indrora/minimole/screenshots-ripple/1.bmp

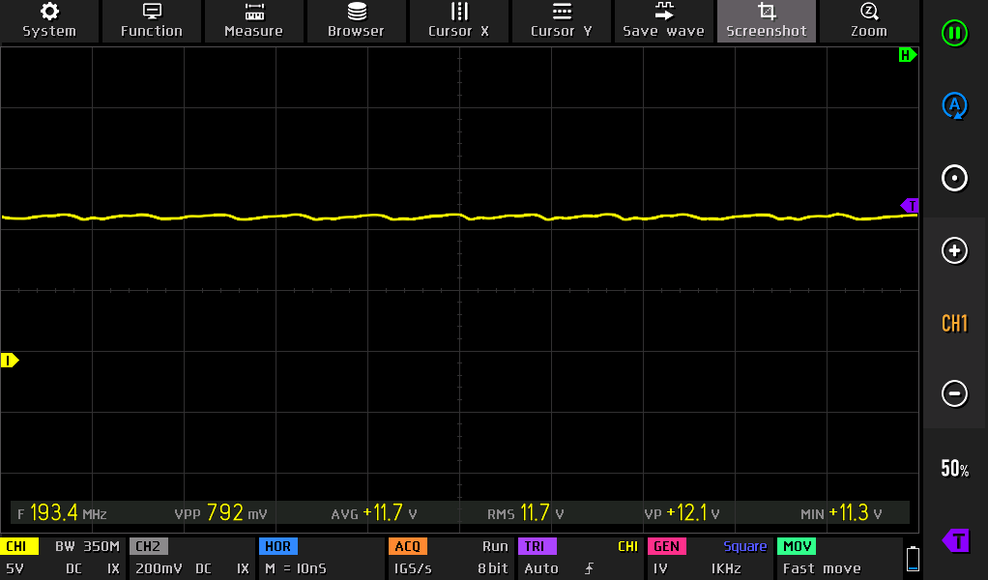
screenshots-ripple/1.bmp
