indrora/minimole/screenshots-ripple/2.bmp

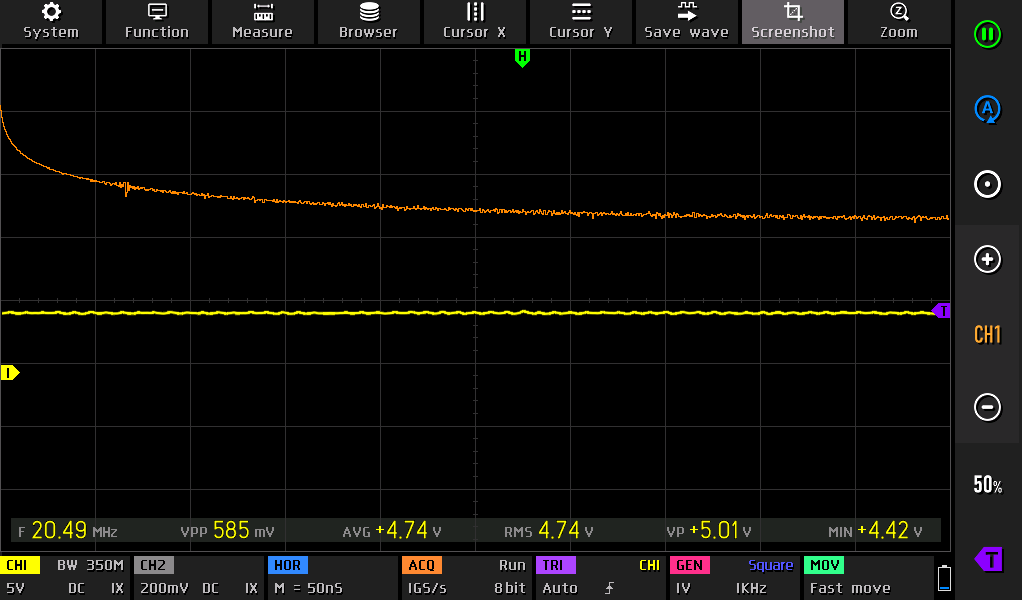
screenshots-ripple/2.bmp
