indrora/minimole/screenshots-ripple/3.bmp

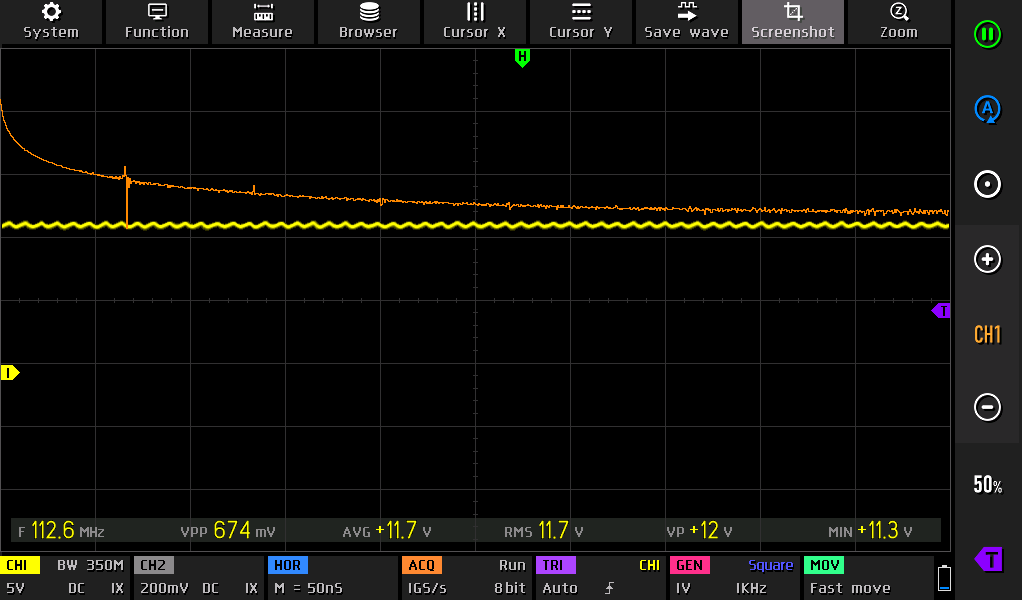
screenshots-ripple/3.bmp
