indrora/minimole/screenshots-ripple/4.bmp

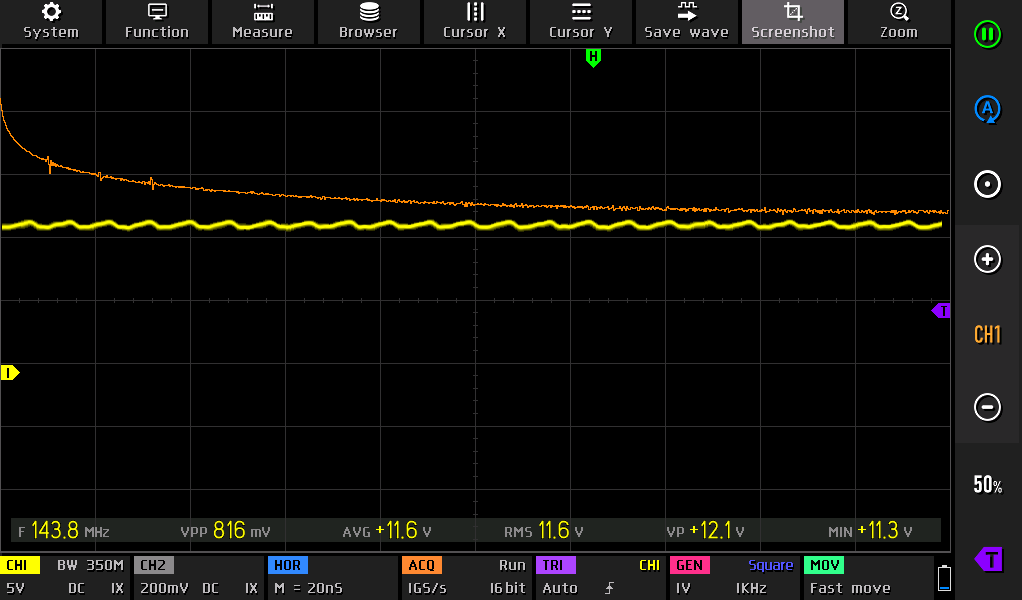
screenshots-ripple/4.bmp
