indrora/minimole/screenshots-ripple/5.bmp

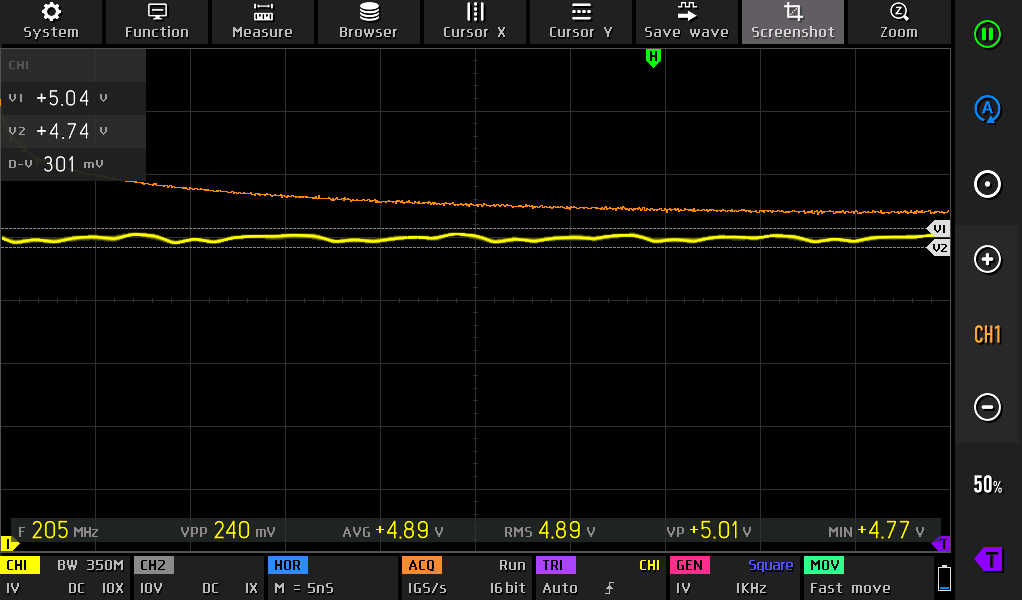
screenshots-ripple/5.bmp
