indrora/minimole/jlcpcb/production_files/BOM-minimole.csv

Comment | Designator | Footprint | LCSC | Quantity
100nF | C14 | C_0603 | C14663 | 1
10kΩ | R1,R11 | R_0402 | C25744 | 2
10uF | C7 | C_0603 | C96446 | 1
18-225A/R6GHW-B01/3T | LED1 | LED-ARRAY-SMD_4P-L1.6-W0.8-BR-RD-2 | C648675 | 1
1812L200/24GR | F1,F2 | F1812 | C18198341 | 2
1kΩ | R3,R9 | R_0402 | C11702 | 2
1uF | C10,C11,C12,C8,C9 | C_0603 | C15849 | 5
2920L200/33GR | F3 | F2920 | C19078743 | 1
4.7kΩ | R10,R4 | R_0402 | C25900 | 2
49.9kΩ | R2 | R_0402 | C25897 | 1
5.1kΩ | R5,R6,R7,R8 | R_0402 | C25905 | 4
AO4805 | Q1 | SOIC-8_L4.9-W3.9-P1.27-LS6.0-BL | C38943 | 1
CL31A106KBHNNNE | C13,C4,C5 | C1206 | C13585 | 3
CYPD3177-24LQXQT_C2952489 | U3 | TQFN-24_L4.0-W4.0-P0.50-TL-EP2.8 | C2952489 | 1
Connector, USB-TYPE-C-16P | J1 | TYPE-C-SMD_HX-TYPE-C-16PIN | C2927039 | 1
EEEFT1V101AP | C1,C2,C3,C6 | CAP-SMD_BD6.3-L6.6-W6.6-FD | C128464 | 4
HC-5557-2*3AW-B-GP-05 | CN1 | CONN-TH_6P-P4.20_HCTL_HC-5557-2X3AW-B-GP-05 | C22398227 | 1
MMBT2222AM3T5G | Q2 | SOT-723-3_L1.2-W0.8-P0.80-LS1.2-BR | C896289 | 1
SS34_C8678 | D1,D2 | SMA_L4.3-W2.6-LS5.2-RD | C8678 | 2
SWPA6045S680MT | L1,L2 | IND-SMD_L6.0-W6.0_SWPA6045S | C53663 | 2
XL1509-12E1 | U1 | SOIC-8_L5.0-W4.0-P1.27-LS6.0-BL | C62594 | 1
XL1509-5.0E1 | U2 | SOIC-8_L5.0-W4.0-P1.27-LS6.0-BL | C61063 | 1
