indrora/minimole/minimole.kicad_pcb

## KiCad design minimole.kicad_pcb (2026-11-06)

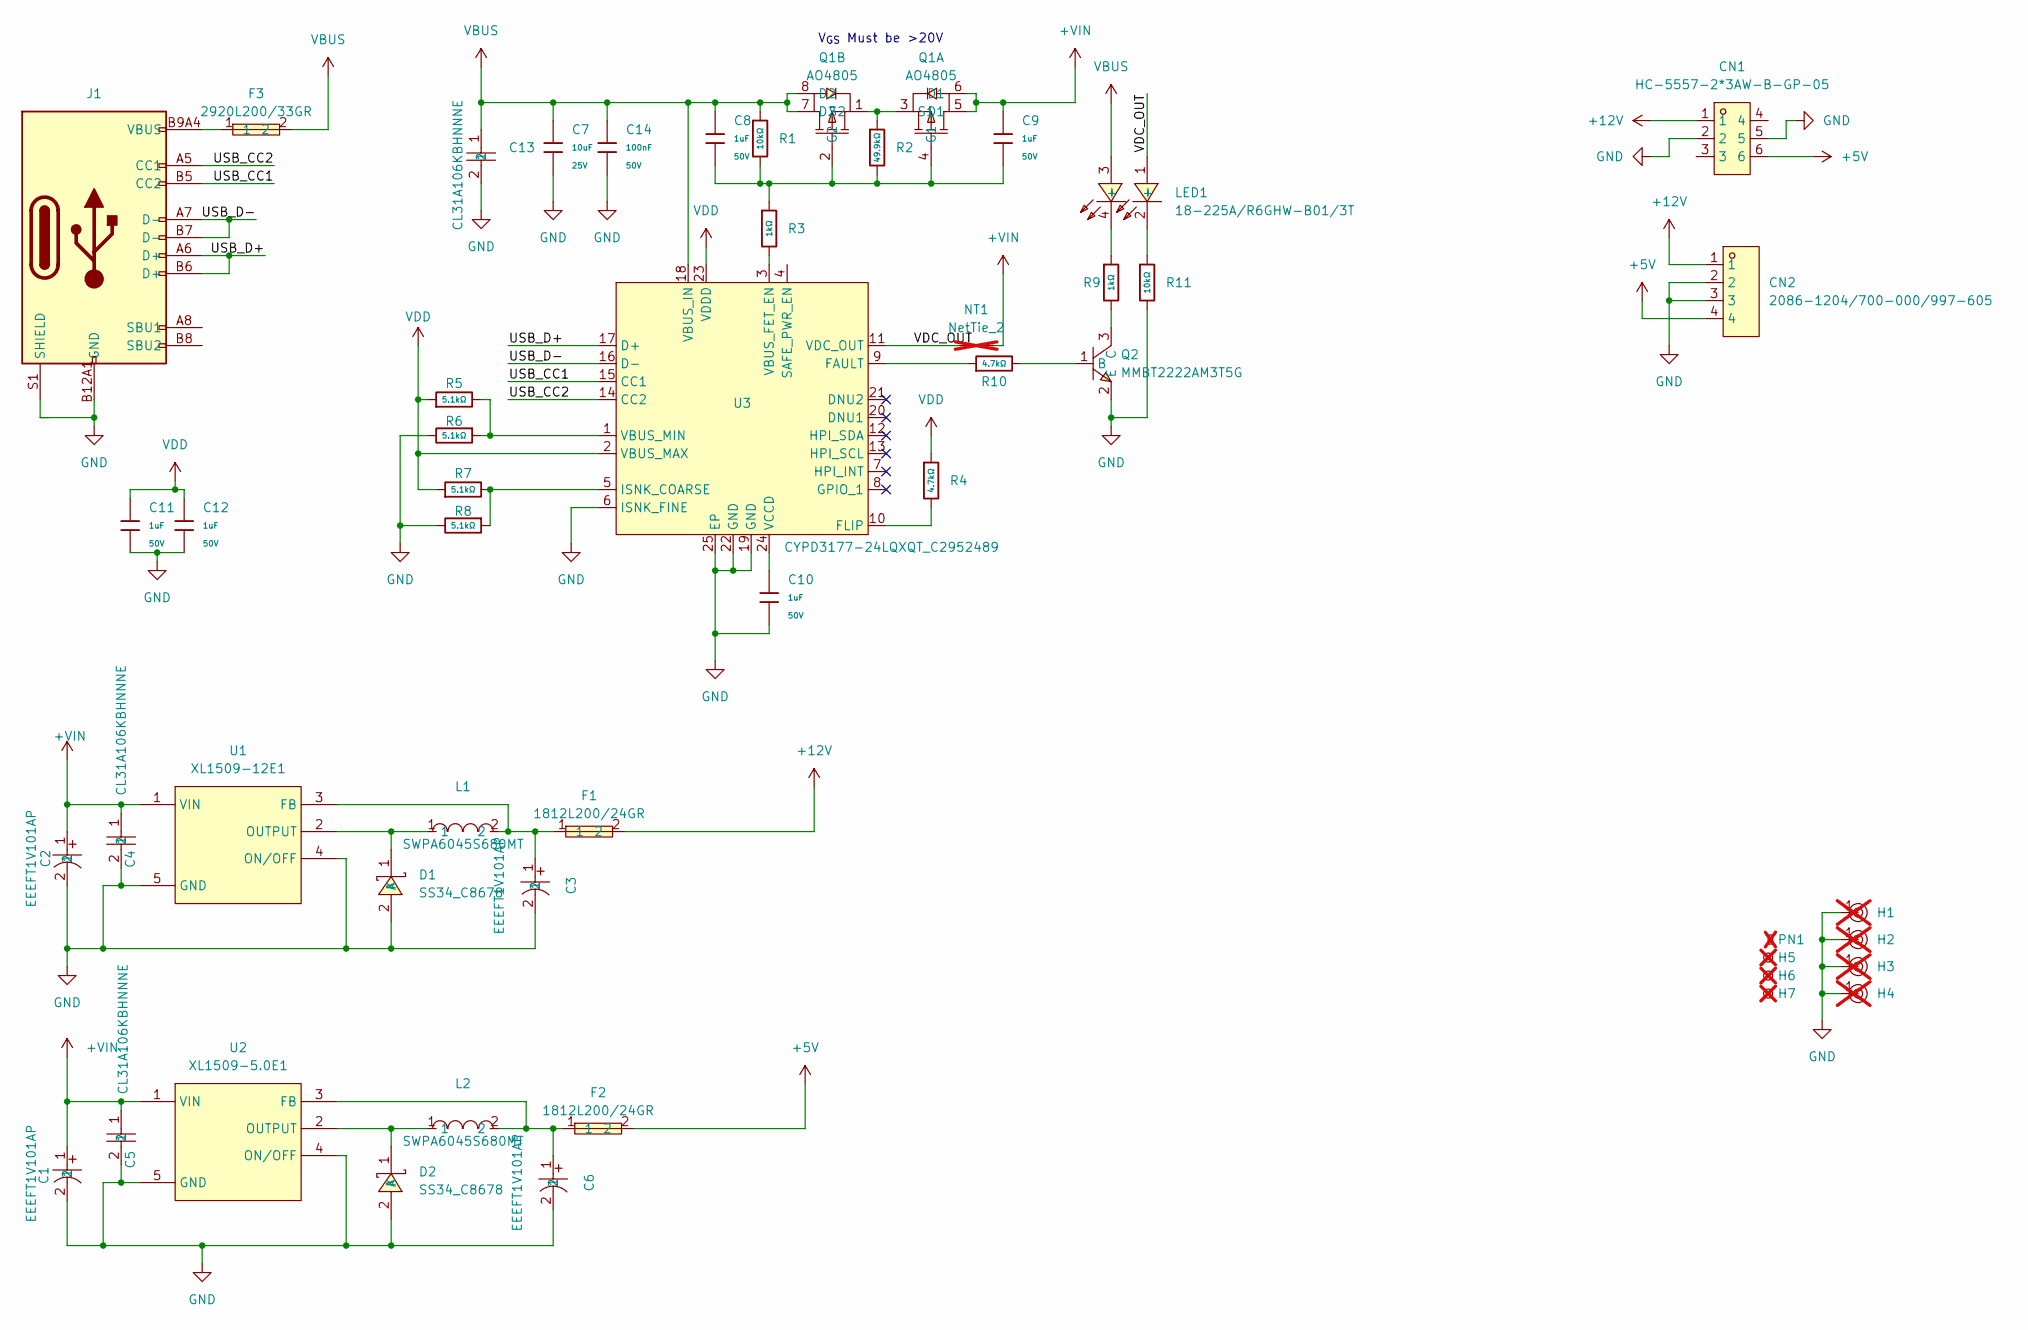
[picture p6: schematic minimole.kicad_sch]

Parts:
C1, C2, C3, C6: EEEFT1V101AP; CAP-SMD_BD6.3-L6.6-W6.6-FD; MPN EEEFT1V101AP; LCSC Part C128464
C4, C5, C13: CL31A106KBHNNNE; C1206; MPN CL31A106KBHNNNE; LCSC Part C13585
C7: 10uF; C_0603; Voltage Rated 25V; Tolerance ±20%; Part CL10A106MA8NRNC; LCSC C96446
C8, C9, C10, C11, C12: 1uF; C_0603; Voltage Rated 50V; Tolerance ±10%; Part CL10A105KB8NNNC; LCSC C15849
C14: 100nF; C_0603; Voltage Rated 50V; Tolerance ±10%; Part CC0603KRX7R9BB104; LCSC C14663
CN1: HC-5557-2*3AW-B-GP-05; CONN-TH_6P-P4.20_HCTL_HC-5557-2X3AW-B-GP-05; MPN HC-5557-2*3AW-B-GP-05; LCSC Part C22398227
CN2: 2086-1204/700-000/997-605; CONN-SMD_4P-P3.50_2086-1204; MPN 2086-1204/700-000/997-605; LCSC Part C3309718
D1, D2: SS34_C8678; SMA_L4.3-W2.6-LS5.2-RD; MPN SS34; LCSC Part C8678
F1, F2: 1812L200/24GR; F1812; MPN 1812L200/24GR; LCSC Part C18198341
F3: 2920L200/33GR; F2920; MPN 2920L200/33GR; LCSC Part C19078743
H1, H2, H3, H4: Hole, 3mm; not fitted
H5, H6, H7: Hole_Tooling_JLCPCB; not fitted
J1: Connector, USB-TYPE-C-16P; TYPE-C-SMD_HX-TYPE-C-16PIN; LCSC C2927039
L1, L2: SWPA6045S680MT; IND-SMD_L6.0-W6.0_SWPA6045S; MPN SWPA6045S680MT; LCSC Part C53663
LED1: 18-225A/R6GHW-B01/3T; LED-ARRAY-SMD_4P-L1.6-W0.8-BR-RD-2; MPN 18-225A/R6GHW-B01/3T; LCSC Part C648675
NT1: NetTie_2; NetTie-2_SMD_Pad0.5mm; not fitted
PN1: Part_Num_JLCPCB; not fitted
Q1: AO4805; SOIC-8_L4.9-W3.9-P1.27-LS6.0-BL; MPN AO4805; LCSC Part C38943
Q2: MMBT2222AM3T5G; SOT-723-3_L1.2-W0.8-P0.80-LS1.2-BR; MPN MMBT2222AM3T5G; LCSC Part C896289
R1, R11: 10kΩ; R_0402; Overload Voltage (Max) 50V; Tolerance ±1%; Part 0402WGF1002TCE; LCSC C25744
R2: 49.9kΩ; R_0402; Overload Voltage (Max) 50V; Tolerance ±1%; Part 0402WGF4992TCE; LCSC C25897
R3, R9: 1kΩ; R_0402; Overload Voltage (Max) 50V; Tolerance ±1%; Part 0402WGF1001TCE; LCSC C11702
R4, R10: 4.7kΩ; R_0402; Overload Voltage (Max) 50V; Tolerance ±1%; Part 0402WGF4701TCE; LCSC C25900
R5, R6, R7, R8: 5.1kΩ; R_0402; Overload Voltage (Max) 50V; Tolerance ±1%; Part 0402WGF5101TCE; LCSC C25905
U1: XL1509-12E1; SOIC-8_L5.0-W4.0-P1.27-LS6.0-BL; MPN XL1509-12E1; LCSC Part C62594
U2: XL1509-5.0E1; SOIC-8_L5.0-W4.0-P1.27-LS6.0-BL; MPN XL1509-5.0E1; LCSC Part C61063
U3: CYPD3177-24LQXQT_C2952489; TQFN-24_L4.0-W4.0-P0.50-TL-EP2.8; MPN CYPD3177-24LQXQT; LCSC Part C2952489

Connections:
+5V: CN1.6, CN2.4, F2.2
+12V: CN1.1, CN2.1, F1.2
+VIN: C1.1, C2.1, C4.1, C5.1, C9.1, NT1.2, Q1.5 (D1), Q1.6 (D1), U1.1 (VIN), U2.1 (VIN)
/USB_CC1: J1.B5 (CC2), U3.15 (CC1)
/USB_CC2: J1.A5 (CC1), U3.14 (CC2)
/USB_D+: J1.A6 (D+), J1.B6 (D+), U3.17 (D+)
/USB_D-: J1.A7 (D-), J1.B7 (D-), U3.16 (D-)
/VDC_OUT: LED1.1 (+), NT1.1, U3.11 (VDC_OUT)
GND: C1.2, C2.2, C3.2, C4.2, C5.2, C6.2, C7.2, C10.2, C11.2, C12.2, C13.2, C14.2, CN1.2, CN1.5, CN2.2, CN2.3, D1.2 (A), D2.2 (A), H1.1, H2.1, H3.1, H4.1, J1.A12B1 (GND), J1.B12A1 (GND), J1.S1 (SHIELD), Q2.2 (E), R6.2, R8.2, R11.2, U1.4 (ON/OFF), U1.5 (GND), U1.6 (GND), U1.7 (GND), U1.8 (GND), U2.4 (ON/OFF), U2.5 (GND), U2.6 (GND), U2.7 (GND), U2.8 (GND), U3.6 (ISNK_FINE), U3.19 (GND), U3.22 (GND), U3.25 (EP)
unnamed: D1.1 (K), L1.1, U1.2 (OUTPUT)
unnamed: D2.1 (K), L2.1, U2.2 (OUTPUT)
unnamed: F3.1, J1.A9B4 (VBUS), J1.B9A4 (VBUS)
unnamed: LED1.2 (-), R11.1
unnamed: LED1.4 (-), R9.1
unnamed: C8.2, C9.2, Q1.2 (G2), Q1.4 (G1), R1.2, R2.2, R3.1
unnamed: Q1.1 (S2), Q1.3 (S1), R2.1
unnamed: Q2.1 (B), R10.2
unnamed: Q2.3 (C), R9.2
unnamed: C3.1, F1.1, L1.2, U1.3 (FB)
unnamed: C6.1, F2.1, L2.2, U2.3 (FB)
unnamed: R10.1, U3.9 (FAULT)
unnamed: R4.2, U3.10 (FLIP)
unnamed: R7.2, R8.1, U3.5 (ISNK_COARSE)
unnamed: R3.2, U3.3 (VBUS_FET_EN)
unnamed: R5.2, R6.1, U3.1 (VBUS_MIN)
unnamed: C10.1, U3.24 (VCCD)
VBUS: C7.1, C8.1, C13.1, C14.1, F3.2, LED1.3 (+), Q1.7 (D2), Q1.8 (D2), R1.1, U3.18 (VBUS_IN)
VDD: C11.1, C12.1, R4.1, R5.1, R7.1, U3.2 (VBUS_MAX), U3.23 (VDDD)

Notes on the sheet:
V_{GS} Must be >20V

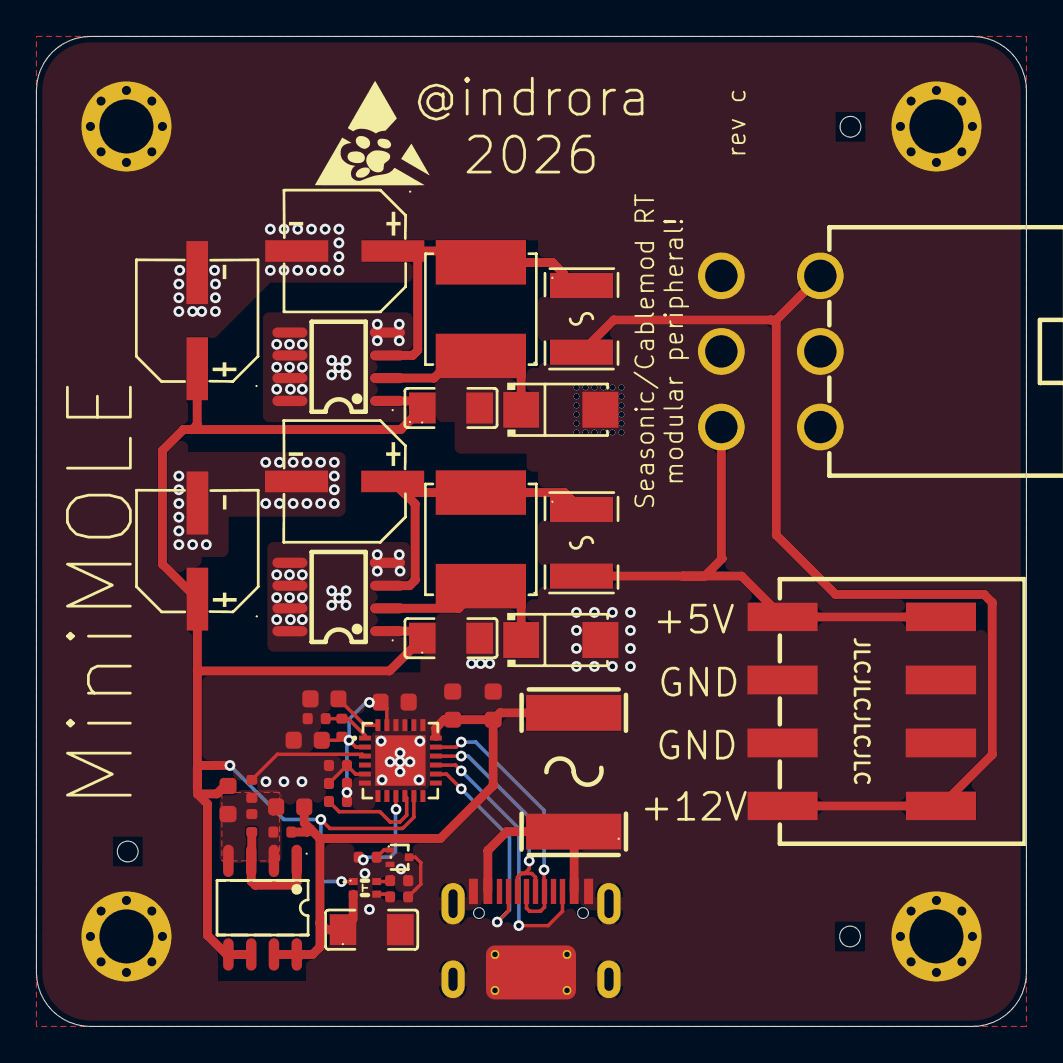
[picture p7: board minimole.kicad_pcb from above]

Board: 2 copper layers, 55.0 x 55.0 mm, 50 parts (0 on the bottom side), 28 nets.
