indrora/minimole/(commit log)

2026-09-22 rev-b: first major pass
    [minimole.kicad_pcb, minimole.kicad_sch]
2026-09-22 rev b: second pass
    [minimole.kicad_pcb, minimole.kicad_sch]
2026-09-22 rev b: pre-prod checkin
    [minimole.kicad_pcb]
2026-10-04 rev c wip
    [minimole.kicad_pcb, minimole.kicad_sch]
2026-10-04 rev b gerbers
    [BOM-minimole.csv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]
2026-11-06 revc: pre-JLCPCB
    [minimole.kicad_pcb, minimole.kicad_sch]
2026-11-06 fix: better thermal isolation
    [minimole.kicad_pcb]
